Y213-178/STM32-EnvMonitor/assets/APP历史数据界面.jpg

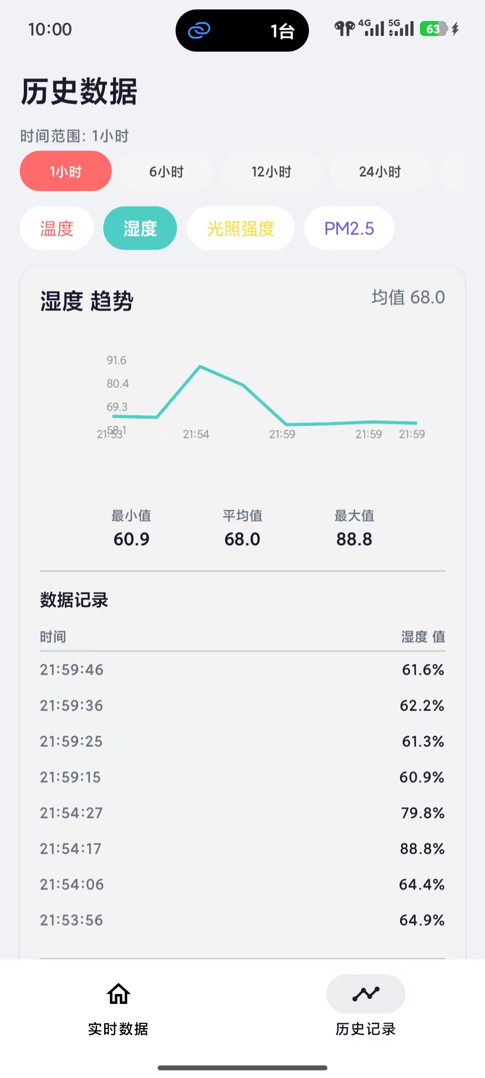
assets/APP历史数据界面.jpg
