Y213-178/STM32-EnvMonitor/assets/APP实时数据界面.jpg

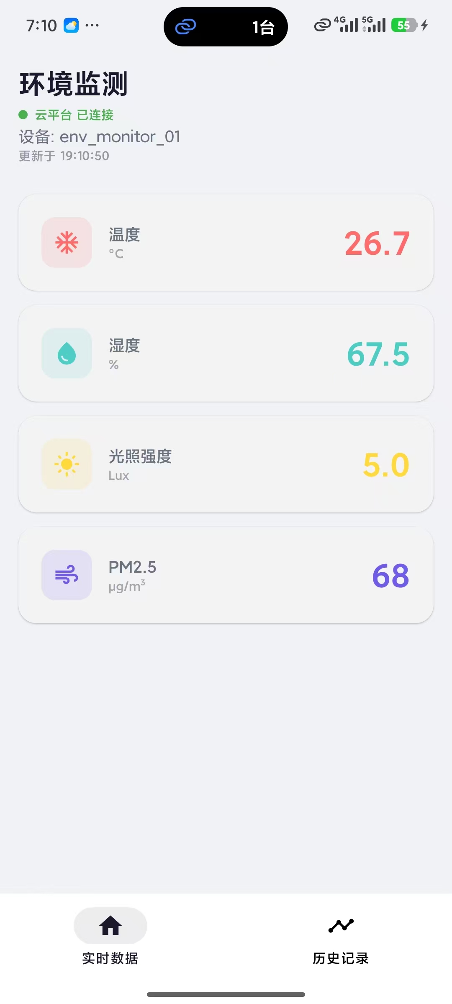
assets/APP实时数据界面.jpg
