Y213-178/STM32-EnvMonitor/assets/串口助手输出.png

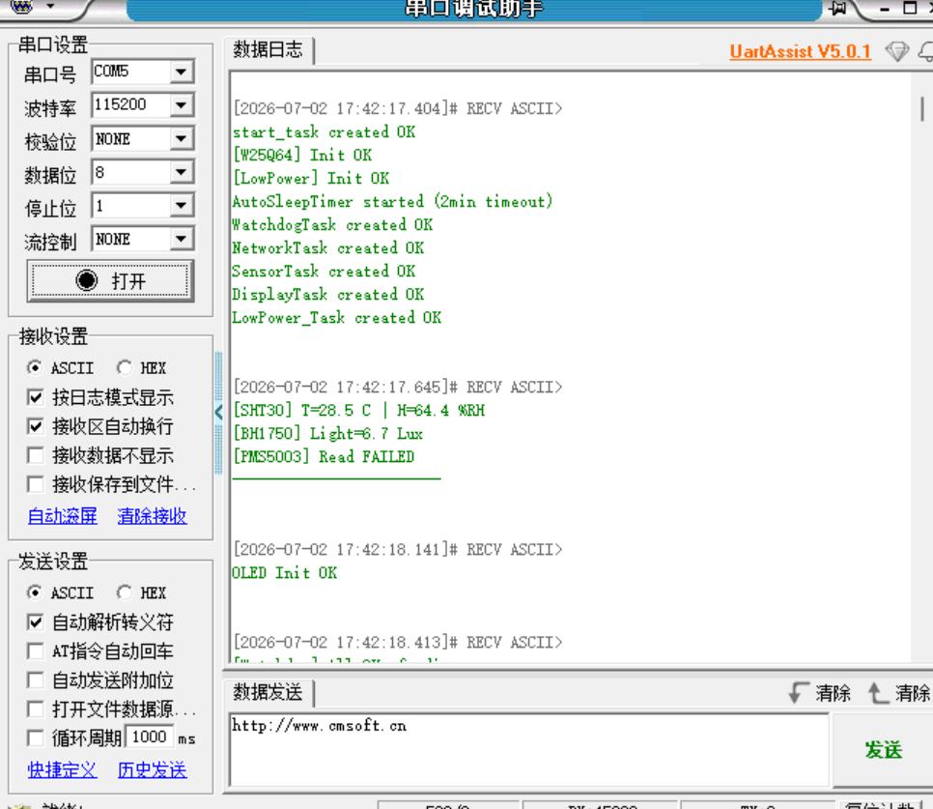
assets/串口助手输出.png
