Y213-178/STM32-EnvMonitor/assets/环境监测节点项目实拍图.jpg

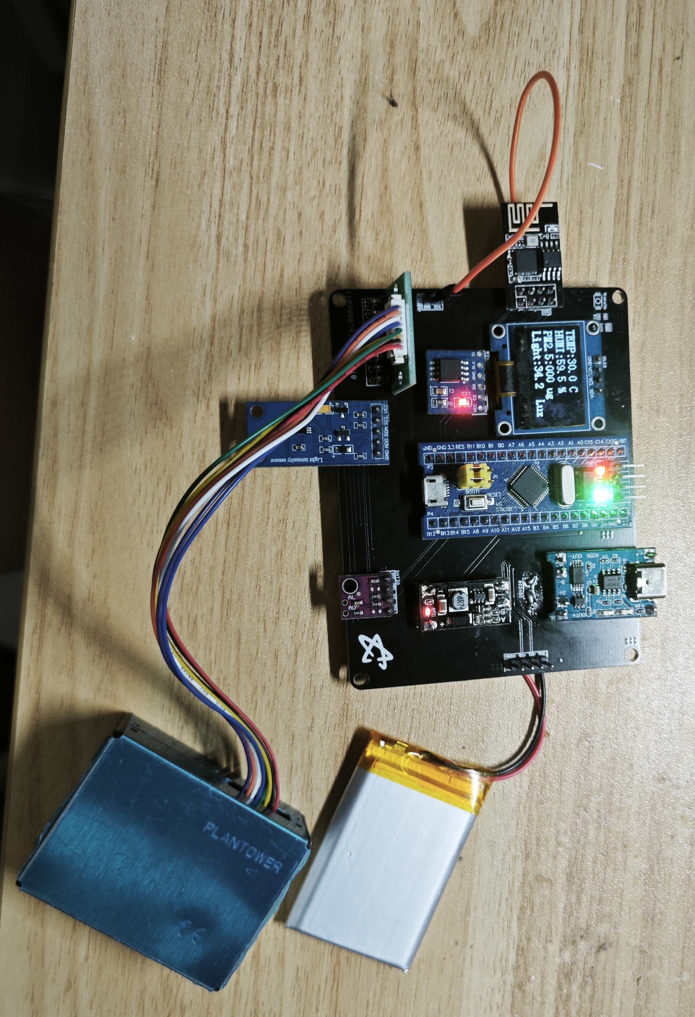
assets/环境监测节点项目实拍图.jpg
