Y213-178/STM32-EnvMonitor/Core/Src/main.c

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
/* Includes ------------------------------------------------------------------*/
#include "main.h"
#include "i2c.h"
#include "rtc.h"
#include "spi.h"
#include "usart.h"
#include "gpio.h"

/* USER CODE BEGIN Includes */
#include "freertos_demo.h"
#include "low_power.h"
#include <stdio.h>
/* USER CODE END Includes */


void SystemClock_Config(void);
/**
  * @brief  The application entry point.
  * @retval int
  */
int main(void)
{

  /* MCU Configuration--------------------------------------------------------*/

  /* Reset of all peripherals, Initializes the Flash interface and the Systick. */
  HAL_Init();

  /* USER CODE BEGIN Init */
  /* 检测 STANDBY 唤醒复位（F1：唤醒后系统复位，PWR_FLAG_SB 置位）。
   * 注意：这里只读标志、不在此清除——rtc.c 的 MX_RTC_Init 需要靠 SB 标志
   * 决定是否跳过 RTC 时间清零（保留跨休眠计时），清标志放到 MX_RTC_Init 之后。 */
  __HAL_RCC_PWR_CLK_ENABLE();
  hrtc.Instance = RTC;
  if (__HAL_PWR_GET_FLAG(PWR_FLAG_SB))
  {
      /* RTC 闹钟标志 ALRAF 在 STANDBY 期间保持置位，可区分唤醒源 */
      if (__HAL_RTC_ALARM_GET_FLAG(&hrtc, RTC_FLAG_ALRAF))
      {
          g_wakeup_reason = WAKEUP_REASON_RTC;
      }
      else
      {
          g_wakeup_reason = WAKEUP_REASON_KEY;
      }
      /* 判定完唤醒源后立即清 ALRAF：MX_RTC_Init 会使能 RTC_Alarm 中断，
       * 若 ALRAF 仍置位会误触发；周期睡眠的闹钟在 STANDBY 里已作为唤醒源用掉。 */
      __HAL_RTC_ALARM_CLEAR_FLAG(&hrtc, RTC_FLAG_ALRAF);
  }
  else
  {
      g_wakeup_reason = WAKEUP_REASON_KEY;   /* 上电/复位启动 */
  }
  /* USER CODE END Init */

  /* Configure the system clock */
  SystemClock_Config();

  /* Initialize all configured peripherals */
  MX_GPIO_Init();
  MX_USART1_UART_Init();
  MX_I2C1_Init();
  MX_SPI1_Init();
  MX_USART2_UART_Init();
  MX_USART3_UART_Init();
  MX_RTC_Init();
  /* USER CODE BEGIN 2 */
  /* 清除 STANDBY 唤醒标志（必须在 MX_RTC_Init 判定唤醒源之后清除） */
  if (__HAL_PWR_GET_FLAG(PWR_FLAG_SB))
  {
      __HAL_PWR_CLEAR_FLAG(PWR_FLAG_SB);
      __HAL_PWR_CLEAR_FLAG(PWR_FLAG_WU);
      printf("[Main] Woke from STANDBY, reason=%s\r\n",
             (g_wakeup_reason == WAKEUP_REASON_RTC) ? "RTC" : "KEY(PA0)");
  }
  else
  {
      printf("[Main] Cold boot\r\n");
  }

  /* 非 RTC 闹钟唤醒（PA0 手动 / 冷启动）→ 常亮模式：
   * 取消上次周期睡眠可能残留的 RTC 闹钟，保证常亮期间不会被拉回睡眠。 */
  if (g_wakeup_reason != WAKEUP_REASON_RTC)
  {
      HAL_RTC_DeactivateAlarm(&hrtc, RTC_ALARM_A);
      __HAL_RTC_ALARM_CLEAR_FLAG(&hrtc, RTC_FLAG_ALRAF);
      printf("[Main] Stale RTC alarm cleared (always-on mode)\r\n");
  }

  freertos_start();

  /* USER CODE END 2 */

  /* Infinite loop */
  /* USER CODE BEGIN WHILE */
  while (1)
  {
    /* USER CODE END WHILE */

    /* USER CODE BEGIN 3 */
  }
  /* USER CODE END 3 */
}

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
/* USER CODE BEGIN 4 */
// 重定向printf到USART1
int fputc(int ch, FILE *f)
{
  HAL_UART_Transmit(&huart1, (uint8_t *)&ch, 1, 0xFFFF);
  return ch;
}
// 可选：重定向scanf（如果不用可以不加）
int fgetc(FILE *f)
{
  uint8_t ch = 0;
  HAL_UART_Receive(&huart1, &ch, 1, 0xFFFF);
  return ch;
}
/* USER CODE END 4 */

/**
  * @brief  Period elapsed callback in non blocking mode
  * @note   This function is called  when TIM2 interrupt took place, inside
  * HAL_TIM_IRQHandler(). It makes a direct call to HAL_IncTick() to increment
  * a global variable "uwTick" used as application time base.
  * @param  htim : TIM handle
  * @retval None
  */
void HAL_TIM_PeriodElapsedCallback(TIM_HandleTypeDef *htim)
{
  if (htim->Instance == TIM2)
  {
    HAL_IncTick();
  }
}

/**
  * @brief  This function is executed in case of error occurrence.
  * @retval None
  */
void Error_Handler(void)
{
  /* USER CODE BEGIN Error_Handler_Debug */
  /* User can add his own implementation to report the HAL error return state */
  __disable_irq();
  while (1)
  {
  }
  /* USER CODE END Error_Handler_Debug */
}
#ifdef USE_FULL_ASSERT
/**
  * @brief  Reports the name of the source file and the source line number
  *         where the assert_param error has occurred.
  * @param  file: pointer to the source file name
  * @param  line: assert_param error line source number
  * @retval None
  */
void assert_failed(uint8_t *file, uint32_t line)
{
  /* USER CODE BEGIN 6 */
  /* User can add his own implementation to report the file name and line number,
     ex: printf("Wrong parameters value: file %s on line %d\r\n", file, line) */
  /* USER CODE END 6 */
}
#endif /* USE_FULL_ASSERT */
