Y213-178/STM32-EnvMonitor/Core/Inc/main.h

#define LED_Pin GPIO_PIN_13
#define LED_GPIO_Port GPIOC
#define CS_Pin GPIO_PIN_4
#define CS_GPIO_Port GPIOA
#define KEY1_Pin GPIO_PIN_1
#define KEY1_GPIO_Port GPIOB
#define KEY1_EXTI_IRQn EXTI1_IRQn
#define KEY2_Pin GPIO_PIN_2
#define KEY2_GPIO_Port GPIOB
