Y213-178/STM32-EnvMonitor/Int/oled.c

#include "oled.h"
#include "stm32f1xx_hal.h"

const uint8_t OLED_F8x16[][16] = {
	{0x00,0x00,0x00,0x00,0x00,0x00,0x00,0x00,0x00,0x00,0x00,0x00,0x00,0x00,0x00,0x00},//  0
	{0x00,0x00,0x00,0xF8,0x00,0x00,0x00,0x00,0x00,0x00,0x00,0x33,0x30,0x00,0x00,0x00},//! 1
	{0x00,0x10,0x0C,0x06,0x10,0x0C,0x06,0x00,0x00,0x00,0x00,0x00,0x00,0x00,0x00,0x00},//" 2
	{0x40,0xC0,0x78,0x40,0xC0,0x78,0x40,0x00,0x04,0x3F,0x04,0x04,0x3F,0x04,0x04,0x00},//# 3
	{0x00,0x70,0x88,0xFC,0x08,0x30,0x00,0x00,0x00,0x18,0x20,0xFF,0x21,0x1E,0x00,0x00},//$ 4
	{0xF0,0x08,0xF0,0x00,0xE0,0x18,0x00,0x00,0x00,0x21,0x1C,0x03,0x1E,0x21,0x1E,0x00},//% 5
	{0x00,0xF0,0x08,0x88,0x70,0x00,0x00,0x00,0x1E,0x21,0x23,0x24,0x19,0x27,0x21,0x10},//& 6
	{0x10,0x16,0x0E,0x00,0x00,0x00,0x00,0x00,0x00,0x00,0x00,0x00,0x00,0x00,0x00,0x00},//' 7
	{0x00,0x00,0x00,0xE0,0x18,0x04,0x02,0x00,0x00,0x00,0x00,0x07,0x18,0x20,0x40,0x00},//( 8
	{0x00,0x02,0x04,0x18,0xE0,0x00,0x00,0x00,0x00,0x40,0x20,0x18,0x07,0x00,0x00,0x00},//) 9
	{0x40,0x40,0x80,0xF0,0x80,0x40,0x40,0x00,0x02,0x02,0x01,0x0F,0x01,0x02,0x02,0x00},//* 10
	{0x00,0x00,0x00,0xF0,0x00,0x00,0x00,0x00,0x01,0x01,0x01,0x1F,0x01,0x01,0x01,0x00},//+ 11
	{0x00,0x00,0x00,0x00,0x00,0x00,0x00,0x00,0x80,0xB0,0x70,0x00,0x00,0x00,0x00,0x00},//, 12
	{0x00,0x00,0x00,0x00,0x00,0x00,0x00,0x00,0x00,0x01,0x01,0x01,0x01,0x01,0x01,0x01},//- 13
	{0x00,0x00,0x00,0x00,0x00,0x00,0x00,0x00,0x00,0x30,0x30,0x00,0x00,0x00,0x00,0x00},//. 14
	{0x00,0x00,0x00,0x00,0x80,0x60,0x18,0x04,0x00,0x60,0x18,0x06,0x01,0x00,0x00,0x00},/// 15
	{0x00,0xE0,0x10,0x08,0x08,0x10,0xE0,0x00,0x00,0x0F,0x10,0x20,0x20,0x10,0x0F,0x00},//0 16
	{0x00,0x10,0x10,0xF8,0x00,0x00,0x00,0x00,0x00,0x20,0x20,0x3F,0x20,0x20,0x00,0x00},//1 17
	{0x00,0x70,0x08,0x08,0x08,0x88,0x70,0x00,0x00,0x30,0x28,0x24,0x22,0x21,0x30,0x00},//2 18
	{0x00,0x30,0x08,0x88,0x88,0x48,0x30,0x00,0x00,0x18,0x20,0x20,0x20,0x11,0x0E,0x00},//3 19
	{0x00,0x00,0xC0,0x20,0x10,0xF8,0x00,0x00,0x00,0x07,0x04,0x24,0x24,0x3F,0x24,0x00},//4 20
	{0x00,0xF8,0x08,0x88,0x88,0x08,0x08,0x00,0x00,0x19,0x21,0x20,0x20,0x11,0x0E,0x00},//5 21
	{0x00,0xE0,0x10,0x88,0x88,0x18,0x00,0x00,0x00,0x0F,0x11,0x20,0x20,0x11,0x0E,0x00},//6 22
	{0x00,0x38,0x08,0x08,0xC8,0x38,0x08,0x00,0x00,0x00,0x00,0x3F,0x00,0x00,0x00,0x00},//7 23
	{0x00,0x70,0x88,0x08,0x08,0x88,0x70,0x00,0x00,0x1C,0x22,0x21,0x21,0x22,0x1C,0x00},//8 24
	{0x00,0xE0,0x10,0x08,0x08,0x10,0xE0,0x00,0x00,0x00,0x31,0x22,0x22,0x11,0x0F,0x00},//9 25
	{0x00,0x00,0x00,0xC0,0xC0,0x00,0x00,0x00,0x00,0x00,0x00,0x30,0x30,0x00,0x00,0x00},//: 26
	{0x00,0x00,0x00,0x80,0x00,0x00,0x00,0x00,0x00,0x00,0x80,0x60,0x00,0x00,0x00,0x00},//; 27
	{0x00,0x00,0x80,0x40,0x20,0x10,0x08,0x00,0x00,0x01,0x02,0x04,0x08,0x10,0x20,0x00},//< 28
	{0x40,0x40,0x40,0x40,0x40,0x40,0x40,0x00,0x04,0x04,0x04,0x04,0x04,0x04,0x04,0x00},//= 29
	{0x00,0x08,0x10,0x20,0x40,0x80,0x00,0x00,0x00,0x20,0x10,0x08,0x04,0x02,0x01,0x00},//> 30
	{0x00,0x70,0x48,0x08,0x08,0x08,0xF0,0x00,0x00,0x00,0x00,0x30,0x36,0x01,0x00,0x00},//? 31
	{0xC0,0x30,0xC8,0x28,0xE8,0x10,0xE0,0x00,0x07,0x18,0x27,0x24,0x23,0x14,0x0B,0x00},//@ 32
	{0x00,0x00,0xC0,0x38,0xE0,0x00,0x00,0x00,0x20,0x3C,0x23,0x02,0x02,0x27,0x38,0x20},//A 33
	{0x08,0xF8,0x88,0x88,0x88,0x70,0x00,0x00,0x20,0x3F,0x20,0x20,0x20,0x11,0x0E,0x00},//B 34
	{0xC0,0x30,0x08,0x08,0x08,0x08,0x38,0x00,0x07,0x18,0x20,0x20,0x20,0x10,0x08,0x00},//C 35
	{0x08,0xF8,0x08,0x08,0x08,0x10,0xE0,0x00,0x20,0x3F,0x20,0x20,0x20,0x10,0x0F,0x00},//D 36
	{0x08,0xF8,0x88,0x88,0xE8,0x08,0x10,0x00,0x20,0x3F,0x20,0x20,0x23,0x20,0x18,0x00},//E 37
	{0x08,0xF8,0x88,0x88,0xE8,0x08,0x10,0x00,0x20,0x3F,0x20,0x00,0x03,0x00,0x00,0x00},//F 38
	{0xC0,0x30,0x08,0x08,0x08,0x38,0x00,0x00,0x07,0x18,0x20,0x20,0x22,0x1E,0x02,0x00},//G 39
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
};

#define OLED_SCL_H()  HAL_GPIO_WritePin(GPIOB, GPIO_PIN_8, GPIO_PIN_SET)
#define OLED_SCL_L()  HAL_GPIO_WritePin(GPIOB, GPIO_PIN_8, GPIO_PIN_RESET)
#define OLED_SDA_H()  HAL_GPIO_WritePin(GPIOB, GPIO_PIN_9, GPIO_PIN_SET)
#define OLED_SDA_L()  HAL_GPIO_WritePin(GPIOB, GPIO_PIN_9, GPIO_PIN_RESET)

//
static void OLED_Delay_us(uint32_t us)
{
    uint32_t i;
    for(i=0; i<us*10; i++);  //
}

//
static void OLED_I2C_Start(void)
{
    OLED_SDA_H();
    OLED_SCL_H();
    OLED_Delay_us(5);
    OLED_SDA_L();
    OLED_Delay_us(5);
    OLED_SCL_L();
}

//
static void OLED_I2C_Stop(void)
{
    OLED_SDA_L();
    OLED_SCL_H();
    OLED_Delay_us(5);
    OLED_SDA_H();
}

//
static void OLED_I2C_SendByte(uint8_t Byte)
{
    uint8_t i;
    for(i=0; i<8; i++)
    {
        if(Byte & (0x80 >> i))
            OLED_SDA_H();
        else
            OLED_SDA_L();
        
        OLED_Delay_us(2);
        OLED_SCL_H();
        OLED_Delay_us(2);
        OLED_SCL_L();
    }
    
    //
    OLED_SCL_H();
    OLED_Delay_us(2);
    OLED_SCL_L();
}

//
static void OLED_WriteCommand(uint8_t Command)
{
    OLED_I2C_Start();
    OLED_I2C_SendByte(0x78);  //
    OLED_I2C_SendByte(0x00);  //
    OLED_I2C_SendByte(Command);
    OLED_I2C_Stop();
}

//
static void OLED_WriteData(uint8_t Data)
{
    OLED_I2C_Start();
    OLED_I2C_SendByte(0x78);  //
    OLED_I2C_SendByte(0x40);  //
    OLED_I2C_SendByte(Data);
    OLED_I2C_Stop();
}

//
//
//
/* 关显示 + 关电荷泵（进 STANDBY 前调用）
 *
 * SSD1306 只清 GDDRAM（OLED_Clear）时，显示屏和内部电荷泵仍然工作，
 * 待机电流约 100~200uA。发 0xAE 关显示、0x8D/0x10 关电荷泵后，
 * 芯片进入睡眠态，电流降到约 10uA。
 *
 * 注意：调用后屏幕全黑且不再响应显示，必须重新 OLED_Init() 才能恢复。 */
void OLED_DisplayOff(void)
{
    OLED_WriteCommand(0xAE);        /* Display OFF */
    OLED_WriteCommand(0x8D);        /* 电荷泵设置 */
    OLED_WriteCommand(0x10);        /* 0x10 = 电荷泵关闭 */
}

//
//)
//)
void OLED_SetCursor(uint8_t Y, uint8_t X)
{
    OLED_WriteCommand(0xB0 | Y);                    //
    OLED_WriteCommand(0x10 | ((X & 0xF0) >> 4));  //
    OLED_WriteCommand(0x00 | (X & 0x0F));          //
}

//
void OLED_Clear(void)
{
    uint8_t i, j;
    for(j=0; j<8; j++)
    {
        OLED_SetCursor(j, 0);
        for(i=0; i<128; i++)
        {
            OLED_WriteData(0x00);
        }
    }
}

//
void OLED_Init(void)
{
    GPIO_InitTypeDef GPIO_InitStruct = {0};

    //
    __HAL_RCC_GPIOB_CLK_ENABLE();

    GPIO_InitStruct.Pin = GPIO_PIN_8 | GPIO_PIN_9;
    GPIO_InitStruct.Mode = GPIO_MODE_OUTPUT_OD;  //
    GPIO_InitStruct.Pull = GPIO_PULLUP;          //
    GPIO_InitStruct.Speed = GPIO_SPEED_FREQ_HIGH;
    HAL_GPIO_Init(GPIOB, &GPIO_InitStruct);

    //
    HAL_GPIO_WritePin(GPIOB, GPIO_PIN_8, GPIO_PIN_SET);
    HAL_GPIO_WritePin(GPIOB, GPIO_PIN_9, GPIO_PIN_SET);

    //
    HAL_Delay(200);

    //
    OLED_WriteCommand(0xAE);  //
    OLED_WriteCommand(0xD5);  //
    OLED_WriteCommand(0x80);
    OLED_WriteCommand(0xA8);  //
    OLED_WriteCommand(0x3F);
    OLED_WriteCommand(0xD3);  //
    OLED_WriteCommand(0x00);
    OLED_WriteCommand(0x40);  //
    OLED_WriteCommand(0xA1);  //
    OLED_WriteCommand(0xC8);  //
    OLED_WriteCommand(0xDA);  //
    OLED_WriteCommand(0x12);
    OLED_WriteCommand(0x81);  //
    OLED_WriteCommand(0xCF);
    OLED_WriteCommand(0xD9);  //
    OLED_WriteCommand(0xF1);
    OLED_WriteCommand(0xDB);  //
    OLED_WriteCommand(0x30);
    OLED_WriteCommand(0xA4);  //
    OLED_WriteCommand(0xA6);  //
    OLED_WriteCommand(0x8D);  //
    OLED_WriteCommand(0x14);
    OLED_WriteCommand(0xAF);  //

    OLED_Clear();
}

//
//
//
void OLED_ShowChar(uint8_t Line, uint8_t Column, char Char)
{
    uint8_t i;
    //
    OLED_SetCursor((Line - 1) * 2, (Column - 1) * 8);
    for(i=0; i<8; i++)
    {
        OLED_WriteData(OLED_F8x16[Char - ' '][i]);  //
    }
    //
    OLED_SetCursor((Line - 1) * 2 + 1, (Column - 1) * 8);
    for(i=8; i<16; i++)
    {
        OLED_WriteData(OLED_F8x16[Char - ' '][i]);  //
    }
}

//
void OLED_ShowString(uint8_t Line, uint8_t Column, char *String)
{
    uint8_t i;
    for(i=0; String[i]!='\0'; i++)
    {
        OLED_ShowChar(Line, Column + i, String[i]);
    }
}

//
uint32_t OLED_Pow(uint32_t X, uint32_t Y)
{
    uint32_t Result = 1;
    while(Y--)
    {
        Result *= X;
    }
    return Result;
}

void OLED_ShowNum(uint8_t Line, uint8_t Column, uint32_t Number, uint8_t Length)
{
    uint8_t i;
    for(i=0; i<Length; i++)
    {
        OLED_ShowChar(Line, Column + i, Number / OLED_Pow(10, Length - i - 1) % 10 + '0');
    }
}

//
void OLED_ShowFloat(uint8_t Line, uint8_t Column, float Number, uint8_t DecLength)
{
    char buf[16];
    memset(buf, 0, sizeof(buf));
    sprintf(buf, "%.*f", DecLength, Number);
    OLED_ShowString(Line, Column, buf);
}
