Y213-178/STM32-EnvMonitor/Int/oled.h

#ifndef __OLED_H
#define __OLED_H

#ifdef __cplusplus
extern "C" {
#endif

#include "main.h"
#include <stdint.h>
#include <string.h>
#include <stdio.h>

// 核心功能函数
void OLED_Init(void);
void OLED_Clear(void);
void OLED_DisplayOff(void);
void OLED_SetCursor(uint8_t Y, uint8_t X);
void OLED_ShowChar(uint8_t Line, uint8_t Column, char Char);
void OLED_ShowString(uint8_t Line, uint8_t Column, char *String);
void OLED_ShowNum(uint8_t Line, uint8_t Column, uint32_t Number, uint8_t Length);
void OLED_ShowFloat(uint8_t Line, uint8_t Column, float Number, uint8_t DecLength);

#ifdef __cplusplus
}
#endif

#endif
