Y213-178/STM32-EnvMonitor/(commit log)

2026-07-03 Initial commit: STM32 environment monitoring node + Android app
2026-10-20 feat: 3.0 改版 —— 电源架构重构、回补式同步、凭据脱敏
    固件
    - 新增 battery.c/h：寄存器级 ADC 采样 + EMA 滤波 + 电量百分比换算
    - 新增电池低压保护：低于 3.40V 自动关机，避免过放损伤
    - 完善睡前关断序列：OLED 关显示 / BH1750 掉电 / W25Q 深度掉电
    - 上报 JSON 增加 battery 字段，配合 OneNET 物模型
    Android
    - 新增回补式同步：启动时按时间区间从云端补齐缺失历史（最多 7 天）
    - 历史页改 Flow 观察，记录列表与曲线 X 轴均带日期
    - 修复曲线 X 轴标签重复绘制导致的文字重叠
    - 缩短历史页数据流按钮文案，避免被裁切
    安全
    - WiFi 名称/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
2026-10-20 docs: README 增加版本导航，修正 3.0 的过时描述
    - 顶部新增「当前版本 3.0」横幅与版本说明表（含 1.0 → 3.0 关键改动对比）
    - 移除已删除的 IWDG 看门狗相关描述（WatchdogTask / iwdg.c 实际不存在）
    - 更新硬件清单：电池 603450 → 703048/1200mAh、W25Q64 → W25Q64/W25Q128
    - 补充电池检测（ADC1_IN1）与 300µA 功耗构成说明
2026-10-20 docs: README 重写为 3.0 独立介绍，替换全部实拍图
    图片
    - 删除 v1.0 原型期的 4 张旧图（蓝色模块搭建的照片）
    - 换成 3.0 紫色 PCB 的 10 张实拍/截图：整机正反面、PCB 3D、
    电源原理图、OLED 显示、App 实时/历史、OneNET 控制台、串口日志
    - 改用英文文件名，体积从 5.7 MB 降到 2.33 MB
    README
    - 从基于前一版的改版说明改为独立项目介绍，新访客可直接看懂
    - 新增核心数据表、双轨电源树、三种工作模式、300µA 功耗拆解
    - 补充电池管理（ADC + EMA 滤波 + 低压保护）与 App 回补式同步章节
    - 快速开始补充占位符填写说明与 OneNET 物模型配置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
