Y213-178/STM32-EnvMonitor/(notices)

Notices in the files:
Core/Src/rtc.c:
Copyright (c) 2026 STMicroelectronics.
All rights reserved.
This software is licensed under terms that can be found in the LICENSE file
